wagiminator/ATtiny412-BatteryCapacityTester/hardware/BatteryCapacityTester_BOM.tsv

ID | Name | Designator | Footprint | Quantity | Manufacturer Part | Manufacturer | Supplier | Supplier Part | Price
1 | CR123A | B1 | TH_L43.0-W-18.0-CR123A | 1 | CR123A电池座 | null | LCSC | C2803347
2 | 18650 | B2 | BH-18650-A | 1
3 | 100n | C1,C3,C4,C6 | C_0603 | 4 | CC0603KRX7R9BB104 | YAGEO | LCSC | C14663 | 0.002
4 | 10u | C2 | C_0603 | 1 | CL10A106KP8NNNC | SAMSUNG | LCSC | C19702 | 0.003
5 | 1u | C5 | C_0603 | 1 | CL10A105KB8NNNC | SAMSUNG | LCSC | C15849 | 0.003
6 | SS34 | D1 | DIODE-SMA(DO-214AC) | 1 | SS34 | MDD | LCSC | C8678 | 0.031
7 | OLED | H1 | I2C OLED 0.96 NEW | 1 | SSD1306 I2C OLED
8 | BAT | J1 | CONN-TH_2P-P2.00_PH-2AW | 1 | PH-2AW RHOS | BOOMELE | LCSC | C16965 | 0.006
9 | BAT | J2 | HEADER_2X1 | 1 |  |  | LCSC | C124375 | 0.022
10 | FAN | J3 | HEADER_2X1 | 1 |  |  | LCSC | C124375 | 0.022
11 | UPDI | J4 | 210S-3X1/2.54 | 1 | Header2.54mm 1*3P | BOOMELE | LCSC | C49257 | 0.015
12 | VOLT | KEY1 | KEY-6.0*6.0 | 1 | SMD Tactile Switch6*6*6mm | ReliaPro | LCSC | C23873 | 0.018
13 | CURRENT | KEY2 | KEY-6.0*6.0 | 1 | SMD Tactile Switch6*6*6mm | ReliaPro | LCSC | C23873 | 0.018
14 | START | KEY3 | KEY-6.0*6.0 | 1 | SMD Tactile Switch6*6*6mm | ReliaPro | LCSC | C23873 | 0.018
15 | IRL540NPBF | Q1 | TO-220-3_L10.0-W4.5-P2.54-T | 1 | IRL540NPBF | Infineon | LCSC | C111607 | 1.144
16 | 10k | R1,R3,R8,R9,R10 | 0603 | 5 | 0603WAF1002T5E | UniOhm | LCSC | C25804
17 | 1k | R2,R5 | 0603 | 2 | 0603WAF1001T5E | UniOhm | LCSC | C21190
18 | R100 | R4 | 2512 | 1 | 25121WF100LT4E | UniOhm | LCSC | C25466 | 0.059
19 | 5k1 | R6,R7 | 0603 | 2 | 0603WAF5101T5E | UniOhm | LCSC | C23186 | 0.001
20 | ATTINY412-SSN | U1 | SOP-8_150MIL | 1 | ATTINY412-SSN | MICROCHIP(美国微芯) | LCSC | C1338223 | 0.577
21 | LMV321 | U2 | SOT-23-5_BR | 1 | LMV321B-TR | 3PEAK | LCSC | C248567 | 0.09
22 | USB-TYPE-C-6PIN | USB1 | USB-C-SMD-6P | 1 | TYPE-C-31-M-17 | Korean Hroparts Elec | LCSC | C283540 | 0.221
