wagiminator/ATtiny412-BatteryCapacityTester/hardware/BatteryCapacityTester_schematic.pdf

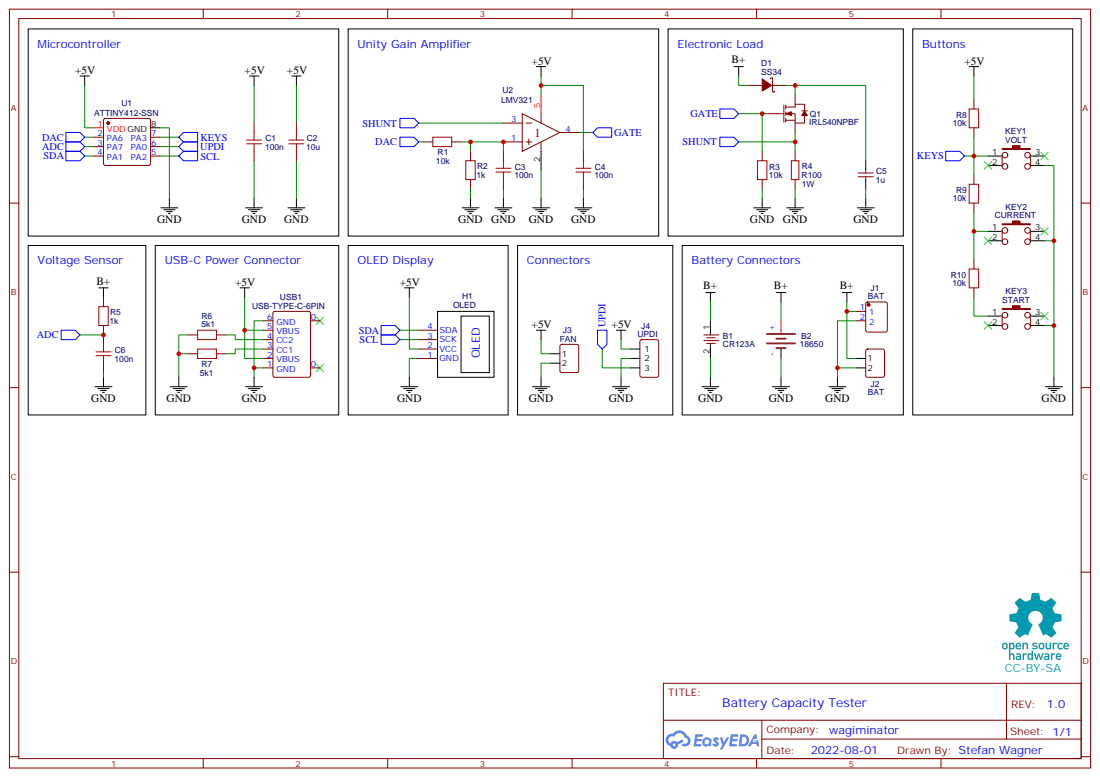
[picture p8: page 1]

Drawn By: Stefan Wagner
